colonelPanic2/sp2023-445/README.md

# sp2023-445
Notebook repository for ECE 445: Spring 2023 (ldavila2, yinshuo3, psarad2)
