colonelPanic2/sp2023-445/notebooks/luis/images/rpi-gpio-pinout.png

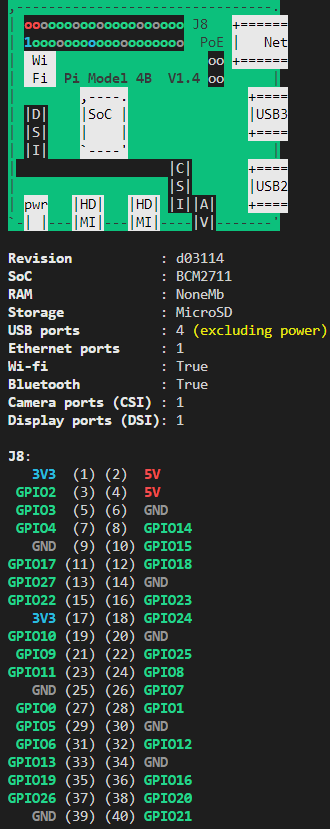
notebooks/luis/images/rpi-gpio-pinout.png
