colonelPanic2/sp2023-445/code/timedata/fetching-tests/test2.png

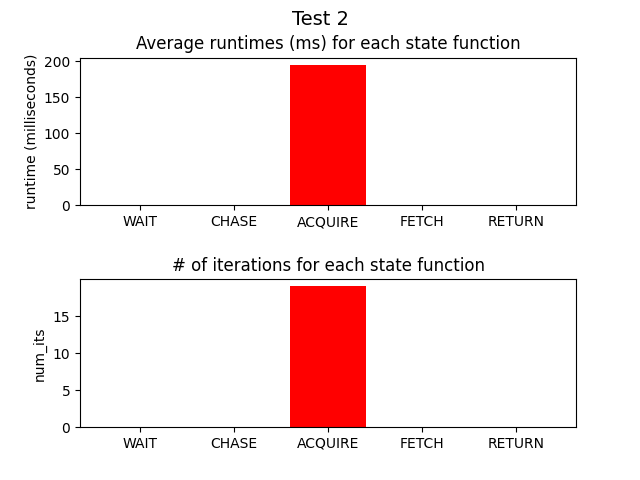
code/timedata/fetching-tests/test2.png
