colonelPanic2/sp2023-445/notebooks/yinshuo/ImageTest/ball2meter.jpg

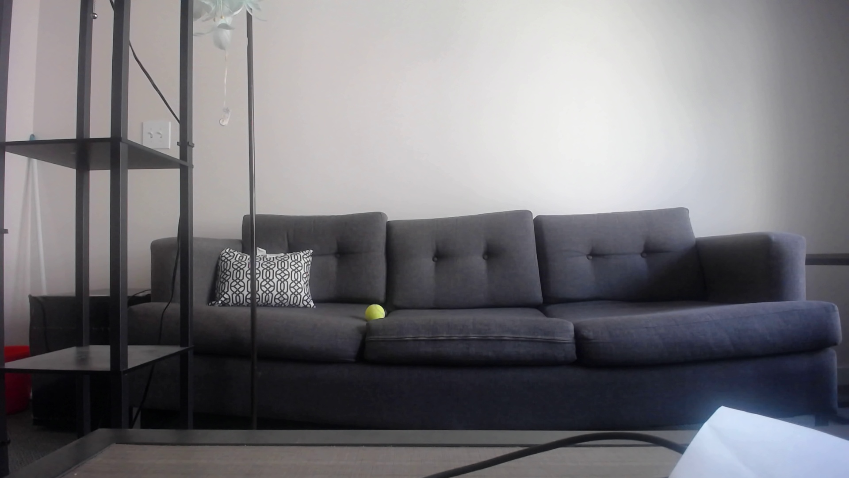
notebooks/yinshuo/ImageTest/ball2meter.jpg
