colonelPanic2/sp2023-445/notebooks/yinshuo/ImageTest/bluesquare.jpg

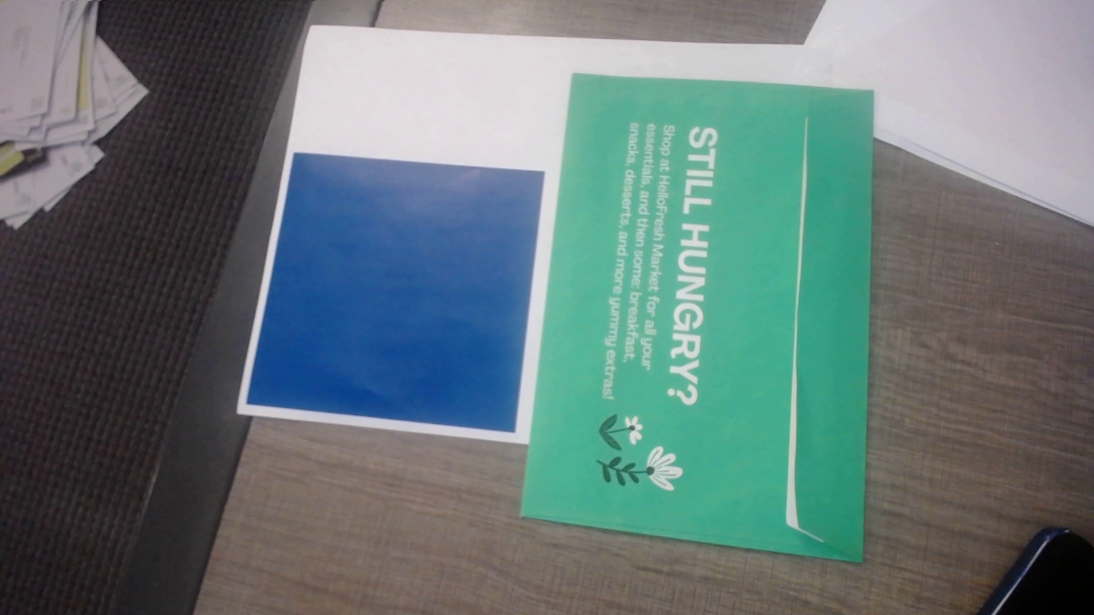
notebooks/yinshuo/ImageTest/bluesquare.jpg
