colonelPanic2/sp2023-445/notebooks/yinshuo/ImageTest/carwheel.jpg

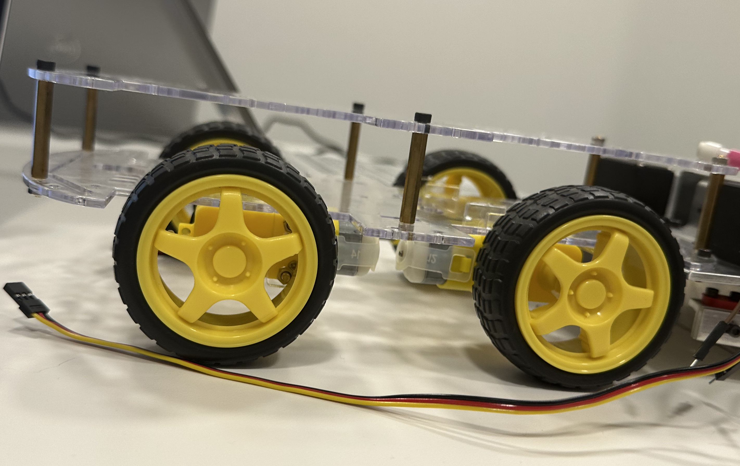
notebooks/yinshuo/ImageTest/carwheel.jpg
