colonelPanic2/sp2023-445/notebooks/yinshuo/ImageTest/green.jpg

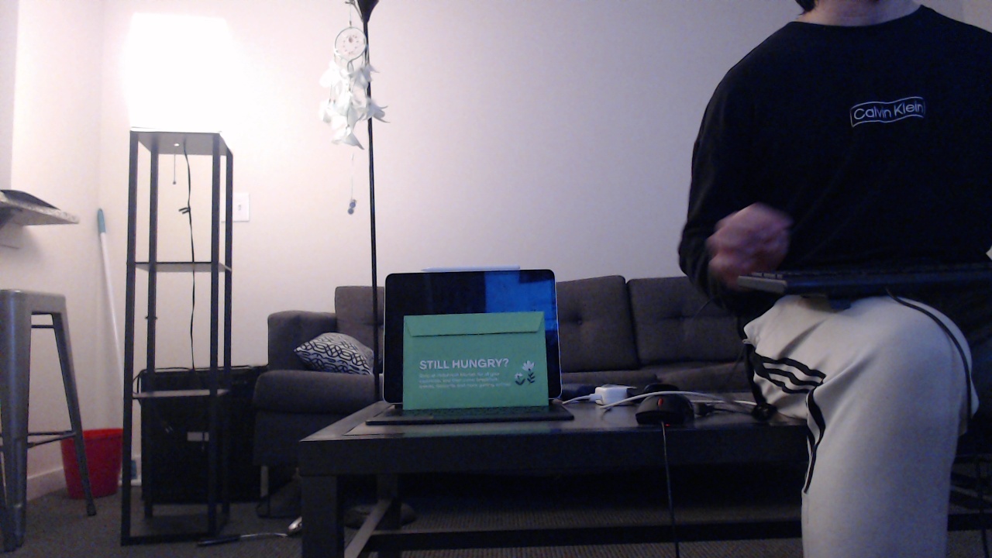
notebooks/yinshuo/ImageTest/green.jpg
