colonelPanic2/sp2023-445/notebooks/yinshuo/ImageTest/object1.jpg

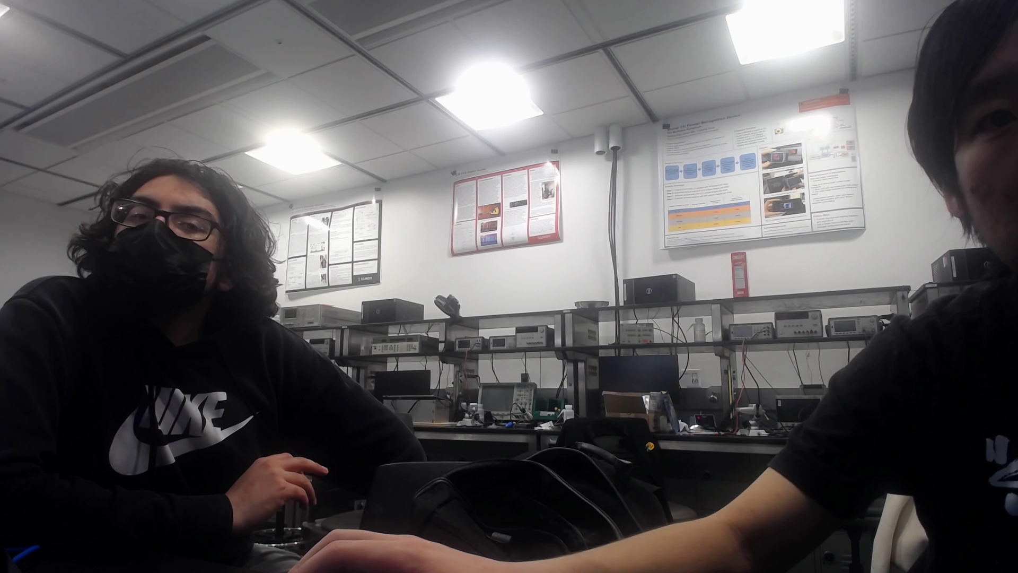
notebooks/yinshuo/ImageTest/object1.jpg
