colonelPanic2/sp2023-445/notebooks/yinshuo/ImageTest/object.jpg

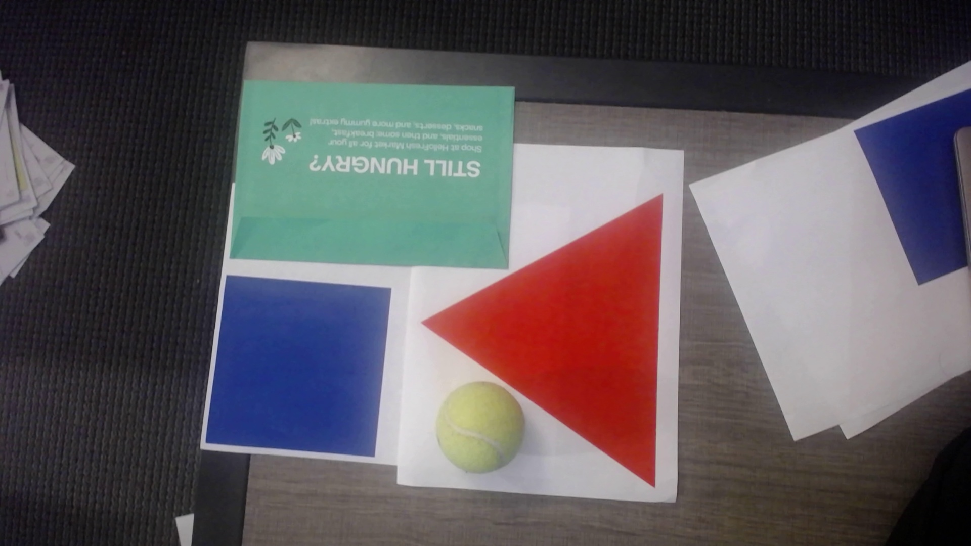
notebooks/yinshuo/ImageTest/object.jpg
