colonelPanic2/sp2023-445/notebooks/yinshuo/ImageTest/pillbox_yellow.jpg

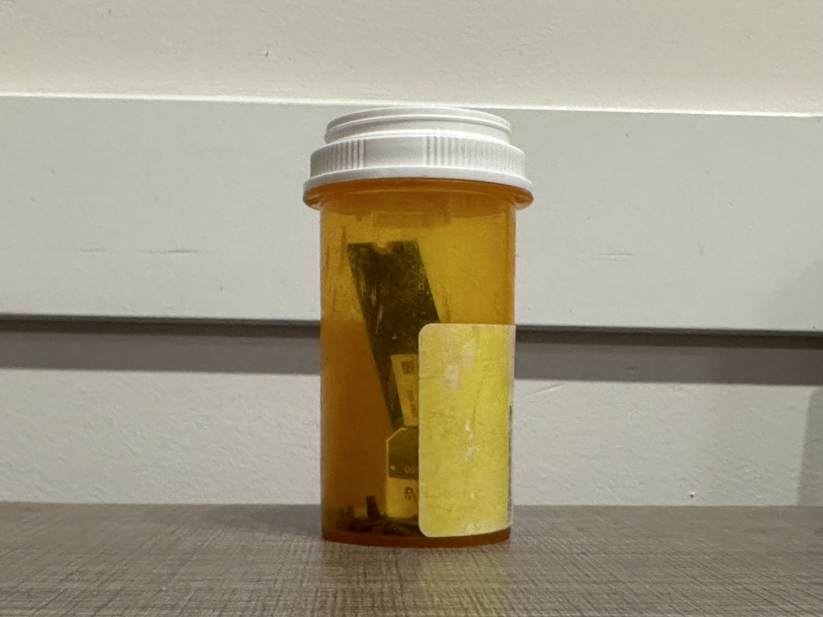
notebooks/yinshuo/ImageTest/pillbox_yellow.jpg
