colonelPanic2/sp2023-445/notebooks/yinshuo/ImageTest/redtriangle.jpg

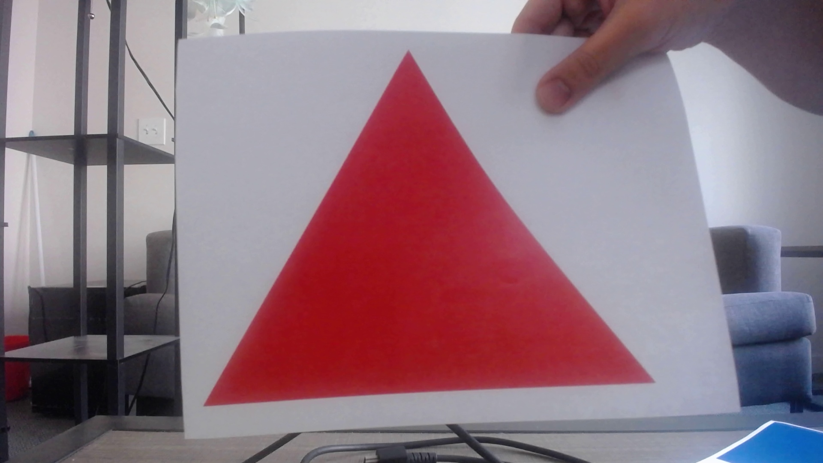
notebooks/yinshuo/ImageTest/redtriangle.jpg
