colonelPanic2/sp2023-445/notebooks/yinshuo/ImageTest/room1.jpg

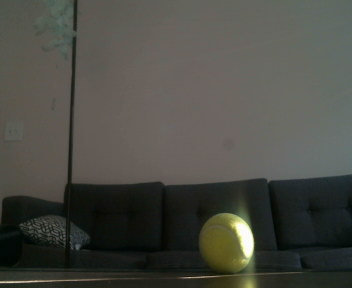
notebooks/yinshuo/ImageTest/room1.jpg
