colonelPanic2/sp2023-445/notebooks/yinshuo/ImageTest/roomlight.jpg

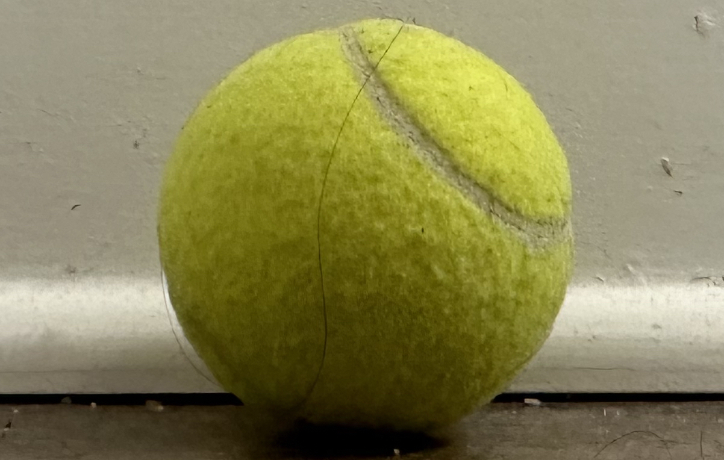
notebooks/yinshuo/ImageTest/roomlight.jpg
