colonelPanic2/sp2023-445/notebooks/yinshuo/ImageTest/roomlight_yellow.jpg

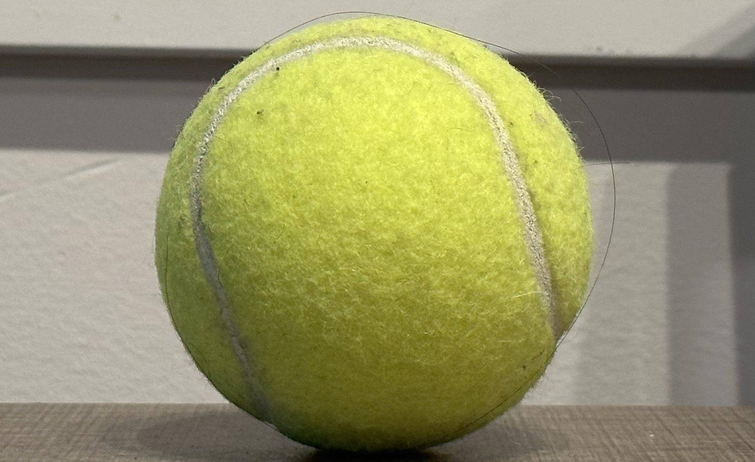
notebooks/yinshuo/ImageTest/roomlight_yellow.jpg
