colonelPanic2/sp2023-445/notebooks/yinshuo/ImageTest/sunlight.jpg

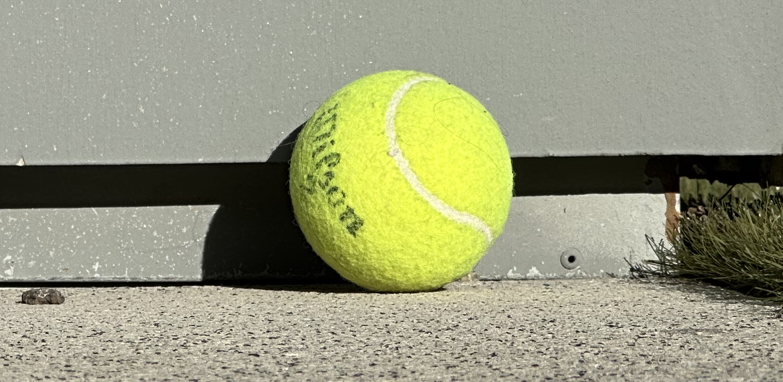
notebooks/yinshuo/ImageTest/sunlight.jpg
