colonelPanic2/sp2023-445/notebooks/yinshuo/ImageTest/testimage1.jpg

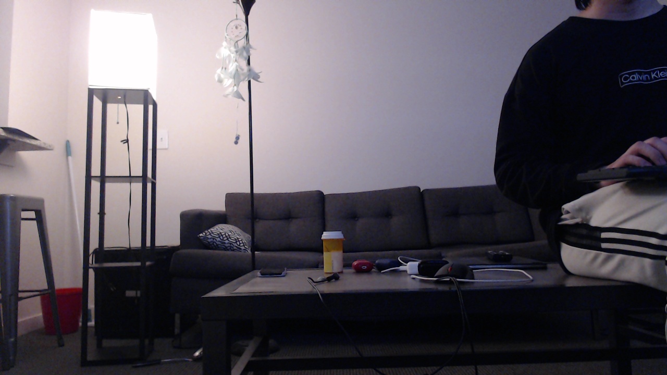
notebooks/yinshuo/ImageTest/testimage1.jpg
