colonelPanic2/sp2023-445/notebooks/yinshuo/ImageTest/two_camera1.jpg

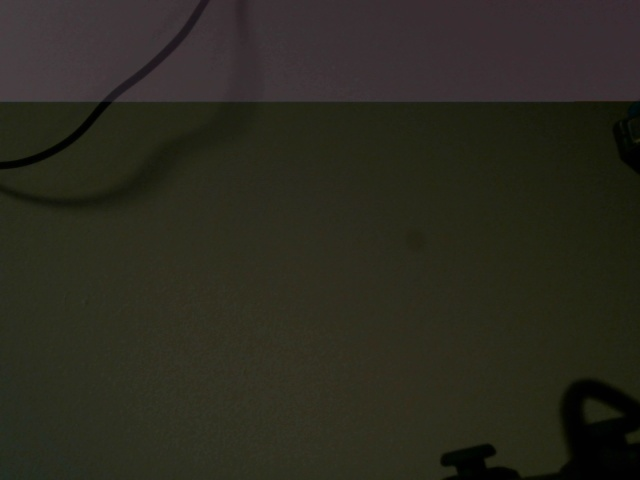
notebooks/yinshuo/ImageTest/two_camera1.jpg
