colonelPanic2/sp2023-445/pcb/pcb.kicad_pcb

## KiCad design pcb/pcb.kicad_pcb (2023-04-22)

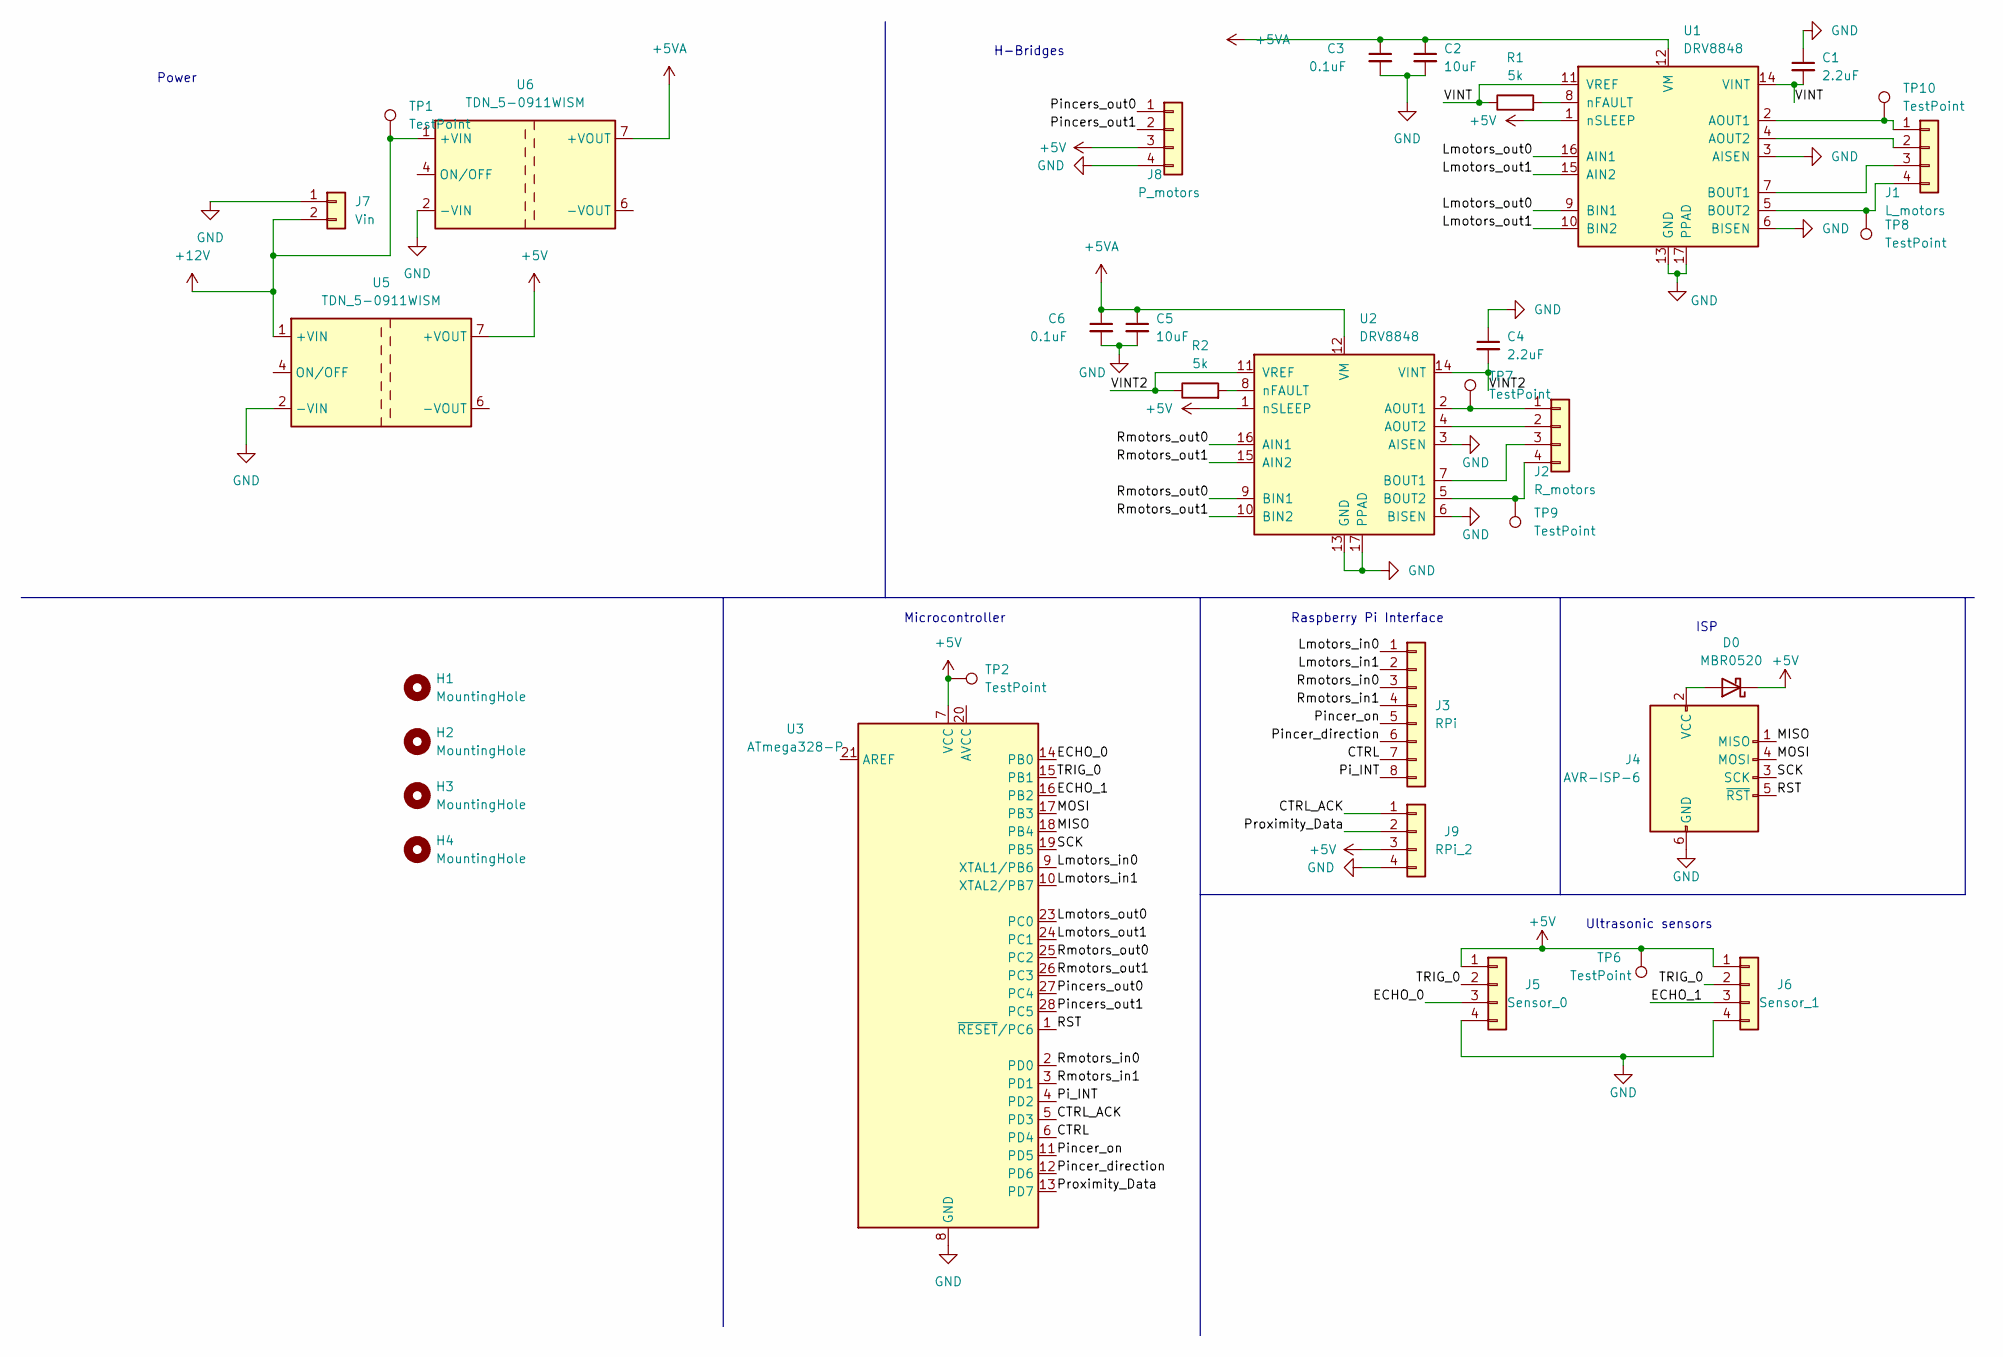
[picture p57: schematic pcb.kicad_sch]

Parts:
C1, C4: 2.2uF; C_1206_3216Metric_Pad1.33x1.80mm_HandSolder
C2, C5: 10uF; C_1210_3225Metric_Pad1.33x2.70mm_HandSolder
C3, C6: 0.1uF; C_1812_4532Metric_Pad1.57x3.40mm_HandSolder
D0: MBR0520; D_SOD-123
H1, H2, H3, H4: MountingHole; MountingHole_3.2mm_M3
J1: L_motors; Molex_KK-254_AE-6410-04A_1x04_P2.54mm_Vertical
J2: R_motors; Molex_KK-254_AE-6410-04A_1x04_P2.54mm_Vertical
J3: RPi; PinSocket_1x08_P2.54mm_Vertical_SMD_Pin1Right
J4: AVR-ISP-6; IDC-Header_2x03_P2.54mm_Vertical
J5: Sensor_0; Molex_KK-254_AE-6410-04A_1x04_P2.54mm_Vertical
J6: Sensor_1; Molex_KK-254_AE-6410-04A_1x04_P2.54mm_Vertical
J7: Vin; Molex_KK-254_AE-6410-02A_1x02_P2.54mm_Vertical
J8: P_motors; Molex_KK-254_AE-6410-04A_1x04_P2.54mm_Vertical
J9: RPi_2; Molex_KK-254_AE-6410-04A_1x04_P2.54mm_Vertical
R1, R2: 5k; R_1206_3216Metric_Pad1.30x1.75mm_HandSolder
TP1, TP2, TP6, TP7, TP8, TP9, TP10: TestPoint; TestPoint_Pad_1.5x1.5mm
U1, U2: DRV8848; TSSOP-16-1EP_4.4x5mm_P0.65mm
U3: ATmega328-P; DIP-28_W7.62mm
U5, U6: TDN_5-0911WISM; Converter_DCDC_TRACO_TDN_5-xxxxWISM_SMD

Connections:
+5V: D0.1 (K), J5.1, J6.1, J8.3, J9.3, TP2.1, TP6.1, U1.1 (nSLEEP), U2.1 (nSLEEP), U3.7 (VCC), U5.7 (+VOUT)
+5VA: C2.1, C3.1, C5.1, C6.1, U1.12 (VM), U2.12 (VM), U6.7 (+VOUT)
+12V: J7.2, TP1.1, U5.1 (+VIN), U6.1 (+VIN)
/CTRL: J3.7, U3.6 (PD4)
/CTRL_ACK: J9.1, U3.5 (PD3)
/ECHO_0: J5.3, U3.14 (PB0)
/ECHO_1: J6.3, U3.16 (PB2)
/Lmotors_in0: J3.1, U3.9 (XTAL1/PB6)
/Lmotors_in1: J3.2, U3.10 (XTAL2/PB7)
/Lmotors_out0: U1.9 (BIN1), U1.16 (AIN1), U3.23 (PC0)
/Lmotors_out1: U1.10 (BIN2), U1.15 (AIN2), U3.24 (PC1)
/MISO: J4.1 (MISO), U3.18 (PB4)
/MOSI: J4.4 (MOSI), U3.17 (PB3)
/Pi_INT: J3.8, U3.4 (PD2)
/Pincer_direction: J3.6, U3.12 (PD6)
/Pincer_on: J3.5, U3.11 (PD5)
/Pincers_out0: J8.1, U3.27 (PC4)
/Pincers_out1: J8.2, U3.28 (PC5)
/Proximity_Data: J9.2, U3.13 (PD7)
/RST: J4.5 (~RST), U3.1 (~RESET/PC6)
/Rmotors_in0: J3.3, U3.2 (PD0)
/Rmotors_in1: J3.4, U3.3 (PD1)
/Rmotors_out0: U2.9 (BIN1), U2.16 (AIN1), U3.25 (PC2)
/Rmotors_out1: U2.10 (BIN2), U2.15 (AIN2), U3.26 (PC3)
/SCK: J4.3 (SCK), U3.19 (PB5)
/TRIG_0: J5.2, J6.2, U3.15 (PB1)
/VINT: C1.2, R1.1, U1.11 (VREF), U1.14 (VINT)
/VINT2: C4.2, R2.1, U2.11 (VREF), U2.14 (VINT)
GND: C1.1, C2.2, C3.2, C4.1, C5.2, C6.2, J4.6 (GND), J5.4, J6.4, J7.1, J8.4, J9.4, U1.3 (AISEN), U1.6 (BISEN), U1.13 (GND), U1.17 (PPAD), U2.3 (AISEN), U2.6 (BISEN), U2.13 (GND), U2.17 (PPAD), U3.8 (GND), U3.22 (GND), U5.2 (-VIN), U6.2 (-VIN)
unnamed: D0.2 (A), J4.2 (VCC)
unnamed: J1.1, TP10.1, U1.2 (AOUT1)
unnamed: J1.2, U1.4 (AOUT2)
unnamed: J1.3, U1.7 (BOUT1)
unnamed: J1.4, TP8.1, U1.5 (BOUT2)
unnamed: J2.1, TP7.1, U2.2 (AOUT1)
unnamed: J2.2, U2.4 (AOUT2)
unnamed: J2.3, U2.7 (BOUT1)
unnamed: J2.4, TP9.1, U2.5 (BOUT2)
unnamed: R1.2, U1.8 (nFAULT)
unnamed: R2.2, U2.8 (nFAULT)

Notes on the sheet:
ISP
Ultrasonic sensors
Raspberry Pi Interface
Microcontroller
H-Bridges
Power

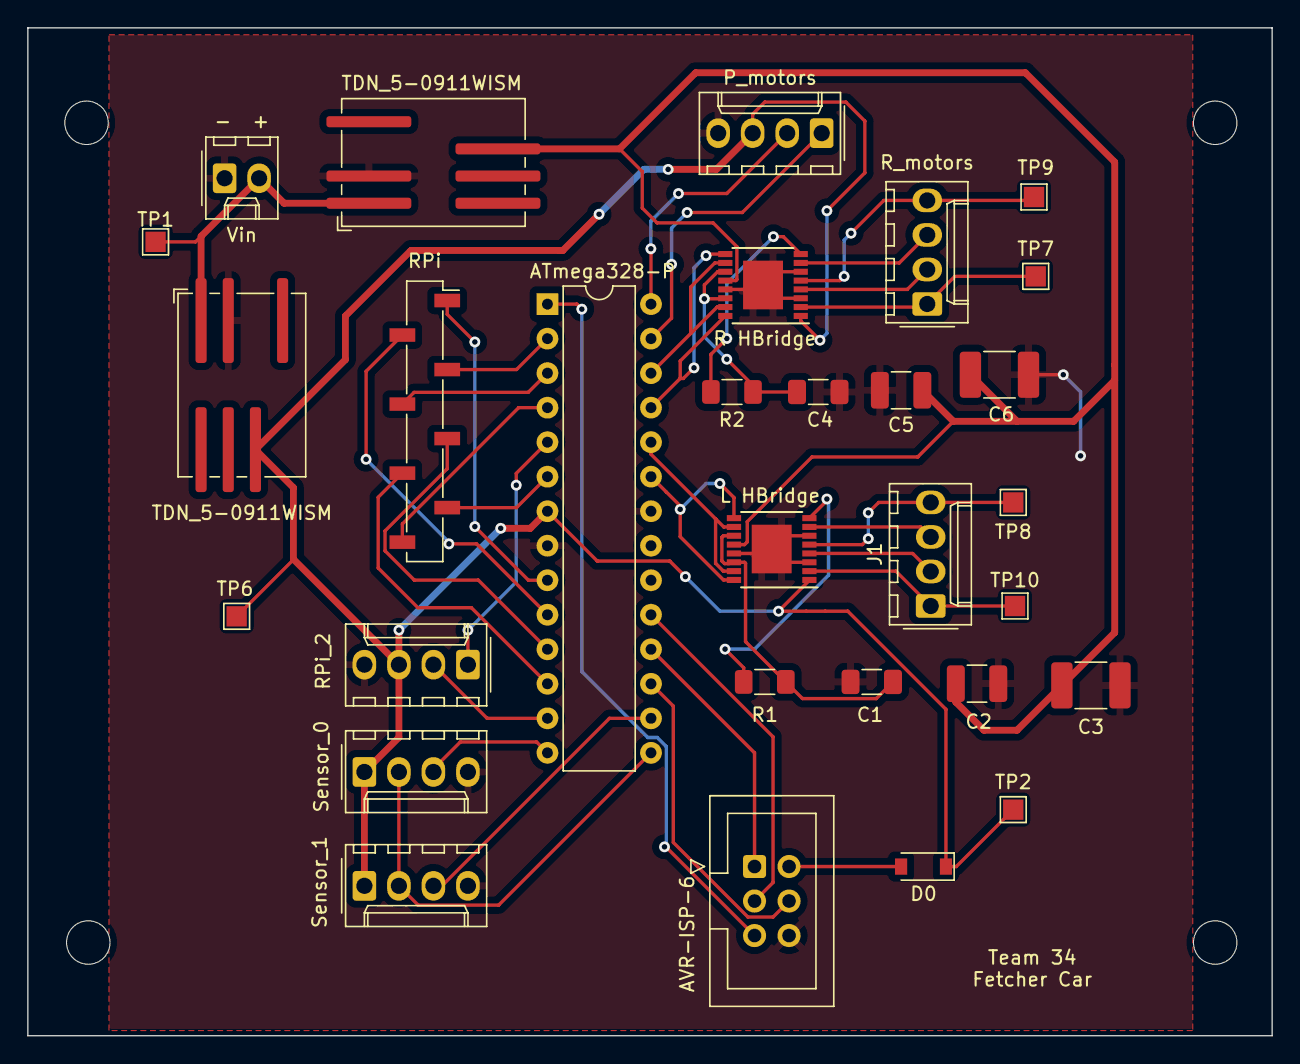
[picture p58: board pcb.kicad_pcb from above]

Board: 2 copper layers, 91.6 x 74.2 mm, 34 parts (0 on the bottom side), 40 nets.
