colonelPanic2/sp2023-445/(commit log)

2023-02-12 Initial files for the PCB
    [pcb.kicad_pcb, pcb.kicad_sch]
2023-02-13 Set up motor controls
2023-02-14 Added more details to the schematic
    [pcb.kicad_sch]
2023-02-19 Trying to implement remote controls for the user.
    [pcb.kicad_sch]
2023-02-19 Added user remote controls for the motors.
2023-03-02 Added some skeleton files for the fetching subsystem. Updated the PCB design.
    [pcb.kicad_sch]
2023-03-13 Finished rough draft of fetching subsystem with temporary randomized logic to simulate getting data from the camera and image processing code.
2023-03-16 Fixed some minor compilation errors in the microcontroller code
    [sketch_mar13a.ino]
2023-03-27 Adding new functionality for automatic randomized data collection. Complementary helper files to delete said data (clear.py) or replace said data (reset.py) have been provided.
    [timedata.csv]
2023-03-31 Added All PCB stuff
    [pcb.kicad_pcb, pcb.kicad_sch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]
2023-04-05 updated camera detection
2023-04-06 Partial implementation of parallelization by process (camera2.py, as opposed to parallelization by threading). Also added option to switch between the old balltracking algorithm and the new one ('old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
2023-04-06 Modified demo code to show that the ball reacts to the position of the ball in the camera view. Added functionality to write process data to files in a new 'logs' directory, and write error outputs t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
2023-04-07 Fixed a few small bugs and failed to integrate the image processing with the timing condition for the transition from the WAIT state to the CHASE state.
    [helpers.py, main.py, state_machine.py]
2023-04-07 Got timing logic to cooperate on teh wait state function. Encountered a flaw in the RETURN state function/transition that appears to translate over to the WAIT state. I haven't looked into the source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
    [state_machine.py]
2023-04-08 Fixed some more minor bugs in the fetching subsystem. Implemented a demo version of our software as the default.
    [gpio.py, helpers.py, main.py, state_machine.py]
2023-04-09 Cleaned up my code and added comments. Identified a bug in the implementation of the 'capture_t' thread in camera.py (in the 'destroy()' function). Modified the command line parsing for main to be mo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
    [timedata.csv]
2023-04-09 Putting the current version of my code on my laptop.
2023-04-10 Adding some changes to prepare for camera-switching
2023-04-10 Got the camera switching working on my laptop
2023-04-11 switching platforms again
2023-04-11 Made some changes to better accomodate cross-platform development and testing on Windows and Linux. Implemented camera switching and consistency of manual controls when switching between cameras.
2023-04-13 small change in the KeyboardInterrupt handling in camera.py
2023-04-13 Fixed the error in the tracking display (added 'shape' argument to 'map_to_block_index')
    [camera.py]
2023-04-13 Fixing a small error in ls (wasn't adding the directory argument when 'dir' was not None)
    [helpers.py]
2023-04-13 Fixed accidental generation of a separate file names 'logfile' in camera.py
    [camera.py]
2023-04-13 Found out that there's no need to call os.kill in the KeyboardInterrupt handling for the 'camera.py' test.
2023-04-13 Did some extra testing to prepare for the mock demo. Added/modified some print statements to properly communicate successful termination of the program.
2023-04-14 Working on implementation of a runtime-sampling system for the fetching subsystem. Once this is working, we should also have access to an easier means of testing the runtime of the microcontroller co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
    [timedata.csv]
2023-04-16 Got the time sampler working for unit-testing individual states without the microcontroller interrupt input. Added changes to state_machine.py, and main.py to prepare for the implementation/integrati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
2023-04-17 Implemented signals for handling microcontroller interrupts. Included a way to confirm that the time sampling for the microcontroller code should work (hold down the '1' key while in manual control m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
    [timedata.csv]
2023-04-17 Adding an example of a full time data sampling
    [microcontroller-runtimes.csv, timedata.csv]
2023-04-19 Some small changes with a note for yinshuo
    [microcontroller-runtimes.csv, timedata.csv]
2023-04-19 Fixed small bug in time_data function and enabled proximity variable toggling when outside of manual mode but in demo mode.
    [camera.py, helpers.py]
2023-04-20 Adding ability to start in any state (except for START) with the rest of the settings as default. Also adding some samples of results from yinshuo's image processing code for the user tracking
2023-04-21 Untested switch from RPi.GPIO to Jetson.GPIO
2023-04-21 Added keyboard debouncing and temporary gpio.py version for the jetson
    [timedata.csv]
2023-04-21 Replaced key releases with spacebar press to fix debouncing issue
    [camera.py, gpio.py]
2023-04-22 Adding the final version of the PCB blueprint
    [pcb.kicad_pcb, pcb.kicad_sch]
2023-04-22 Fixed small bug in the timing tracker
    [gpio.py, main.py]
2023-04-22 Fixing small error with 'init-err.txt' file
    [helpers.py]
2023-04-22 Changes to timedata directory
    [microcontroller-runtimes.csv, timedata.csv]
2023-04-23 Possible changes to the pin mappings
2023-04-23 Remapping pincer pin from GPIO24 to GPIO4
2023-04-23 Fixing camera issues
2023-04-23 Fixing small discrepancy in the SIGINT handlers when switching from manual control mode to auto control mode
    [gpio.py, main.py]
2023-04-23 Multiplying camera index by 2
2023-04-23 Some changes to increase granularity. Also added TODO notes in the control interface helper functions '*_commands()'. Modified some of gpio.py to get rid of useless code left behind from previous com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
2023-04-23 Adding ultrasonic sensor functionality to the Raspberry Pi
2023-04-23 Fixing indexing error with the self.pins list
    [gpio.py]
2023-04-23 Trying to fix image scaling on Pi
    [camera.py]
2023-04-23 Adding changes to the wait times for each state function (in the 'images' class in camera.py)
2023-04-23 Fixing typo in last commit
    [main.py]
2023-04-23 Trying to fix issue with forward/reverse on both motors
    [gpio.py]
2023-04-23 Debouncing the proximity pin
2023-04-23 Adding a potential solution for the motors when exiting the program
2023-04-24 Removing all traces of the camera thread. Configuring the design to open the pincers on startup and close them on proper shutdown.
2023-04-24 Small fix for timing functionality
    [helpers.py]
2023-04-24 Adding an option to interrupt auto control mode with manual control mode when necessary
2023-04-24 Created a special case for the 3 regions at the bottom-center of the screen in 'update_goal_position', modified the state machine to utilitze distances, added a function that uses an ultrasonic senso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
2023-04-24 Removing changes involving the silencing of microcontroller interrupts to the Pi. We won't have time to implement the required functionality properly on the microcontroller
    [gpio.py, main.py, state_machine.py]
2023-04-25 File for keeping track of zombie processes and pi temperature
2023-04-25 Testing gpio activation of the fan
2023-04-25 Fixing small bug in distance function
    [gpio.py]
2023-04-25 Test for automated temperature regulation failed. We'll have to have the fan on constantly.
    [gpio.py]
2023-04-25 Fixed a 'crashing' bug caused by mistakenly ignoring SIGINT signals when exiting manual control mode. Modified some writefile calls in state_machine.py to prepare the system to gather some data
    [gpio.py, state_machine.py]
2023-04-25 Reminder to remove print statements from interrupt handlers
2023-04-25 State machine is working, but display is broken
    [gpio.py, state_machine.py]
2023-04-25 Print statements for debugging with no display
2023-04-25 Extra print statements to check for state changes
2023-04-25 Found the cause of the 'crashing' state machine
    [camera.py, gpio.py, main.py, state_machine.py]
2023-04-25 Clearing timedata.csv to do a timing test
    [timedata.csv]
2023-04-25 Removing print statements
2023-04-25 Removed sleep timers and print statements
2023-04-25 Removing lingering print statements from main.py
2023-04-25 Printing motor instructions to be sent (if not part of a transition state) for each state function
2023-04-25 Ran time sampling program for all 5 states with 100 samples per state
    [timedata.csv]
2023-04-25 Configuring code to handle PROX and CTRL_ACK interrupts from the microcontroller.
2023-04-25 Removing last timedata run (saved locally)
    [timedata.csv]
2023-04-26 Small modifications and average runtimes for each state function over 100 samples each
    [microcontroller-runtimes.csv, timedata.csv]
2023-04-26 Testing time/distance limiter on the ultrasonic sensors attached to the Pi
2023-04-26 Adding optional execution of gpio.py to test ultrasonic sensor functions
2023-04-28 Synchronizing final version of the code on my branch
    [microcontroller-runtimes.csv, timedata.csv]
2023-04-28 Added an image of the second redesign of the PCB and some information about the final state of the Pi software. Need to add more details later.
2023-04-28 Adding the image for the second PCB redesign
2023-04-28 Added most of the imagery and links necessary for my notebook. Still need to fix the time sampling code to enable labelling of the microcontroller's Pi interrupt response times by the state in which 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
2023-04-29 Removed code from my notebook directory
    [microcontroller-runtimes.csv, timedata.csv]
2023-05-02 Correcting the second pin mapping chart
    [camera.py]
