colonelPanic2/sp2023-445/notebooks/yinshuo/Images/IMG_2445.jpg

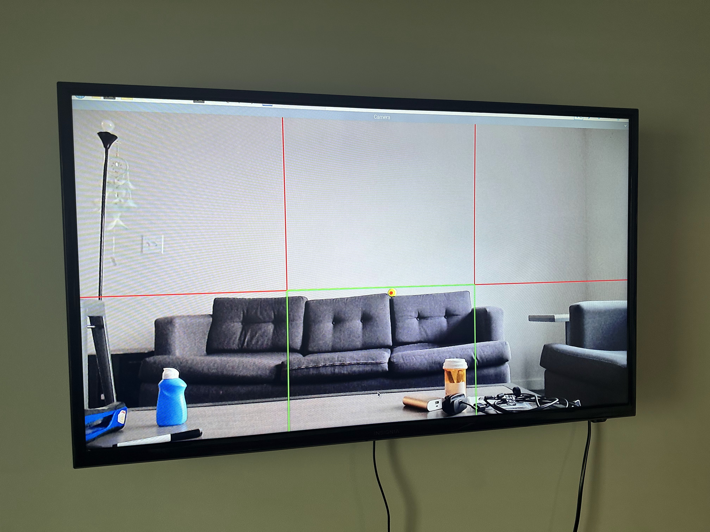
[picture p8: notebooks/yinshuo/Images/IMG_2445.jpg]
notebooks/yinshuo/Images/IMG_2445.jpg
