colonelPanic2/sp2023-445/notebooks/patrick/images/machine_shop_final.jpg

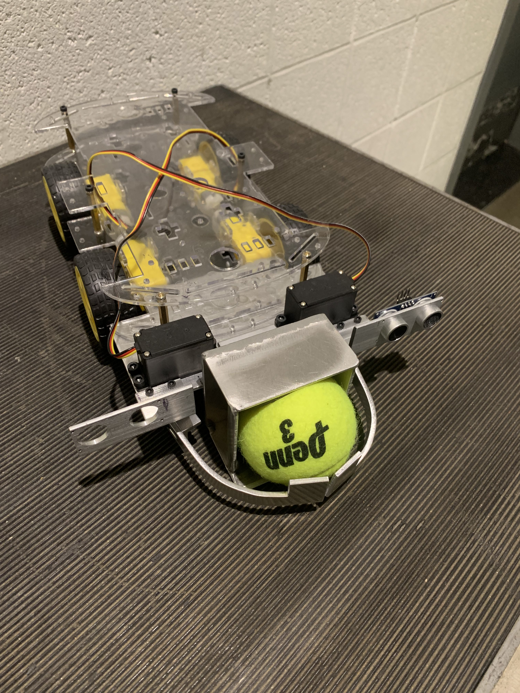
[picture p14: notebooks/patrick/images/machine_shop_final.jpg]
notebooks/patrick/images/machine_shop_final.jpg
