colonelPanic2/sp2023-445/notebooks/patrick/images/buck_converters.jpg

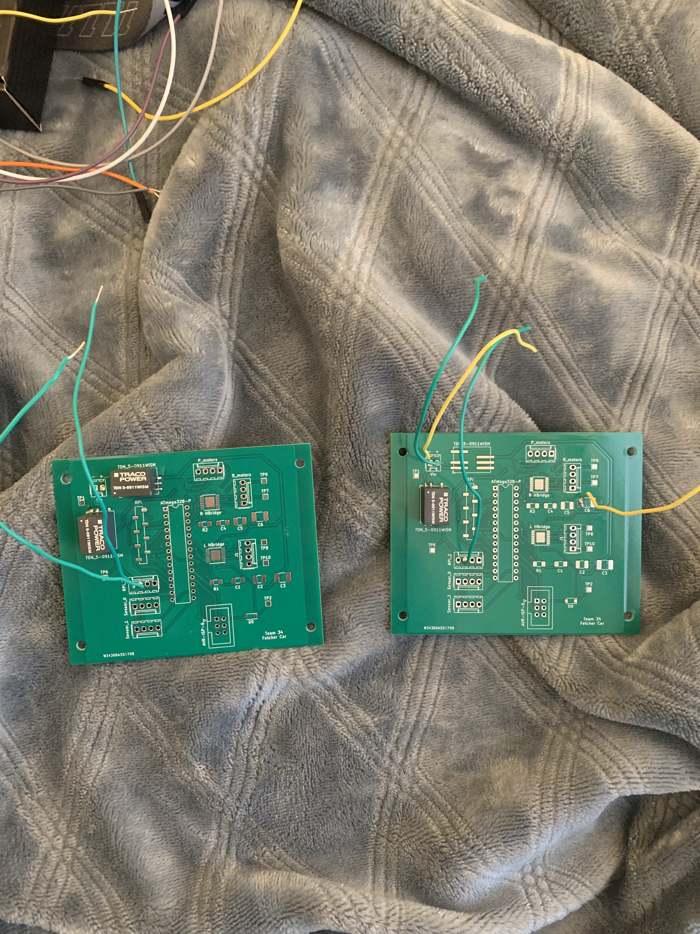
[picture p19: notebooks/patrick/images/buck_converters.jpg]
notebooks/patrick/images/buck_converters.jpg
