colonelPanic2/sp2023-445/notebooks/patrick/images/sensor_test_with_fullCar.jpg

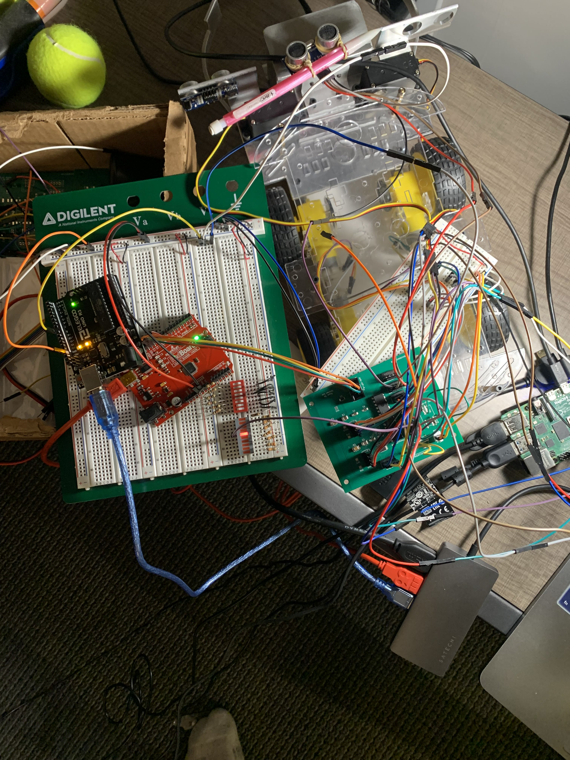
[picture p22: notebooks/patrick/images/sensor_test_with_fullCar.jpg]
notebooks/patrick/images/sensor_test_with_fullCar.jpg
